krimarty/Siteshift_project/doc/treadmill_sideshift_doc/appendix.tex

\appendix
\section{Schematic diagram}
\section{PCB layout TOP (red) and BOTTOM (blue)}

\includepdf[pages=-,landscape]{images/1.0.0_20250715.pdf}

\begin{figure}[h!]
    \centering
    
\end{figure}

\begin{figure}[h!]
    \centering
    
\end{figure}
