krimarty/Siteshift_project/doc/treadmill_sideshift_doc/main.tex

\documentclass{ol-softwaremanual}

% Packages used in this example
\usepackage{graphicx}  % for including images
\usepackage{microtype} % for typographical enhancements
\usepackage{minted}    % for code listings
\usepackage{amsmath}   % for equations and mathematics
\setminted{style=friendly,fontsize=\small}
\renewcommand{\listoflistingscaption}{List of Code Listings}
\usepackage{hyperref}  % for hyperlinks
\usepackage[a4paper,top=4.2cm,bottom=4.2cm,left=3.5cm,right=3.5cm]{geometry} % for setting page size and margins
\usepackage{svg} % práce se SVG
\usepackage{xcolor}
\usepackage{dirtree}
\usepackage{pdfpages}

\newif\ifnotes
\notestrue   % ukázat poznámky
%\notesfalse

% příkaz pro poznámky
\newcommand{\note}[1]{%
  \ifnotes
    \textcolor{red}{#1}%
  \fi
}

% Custom macros used in this example document
\newcommand{\doclink}[2]{\href{#1}{#2}\footnote{\url{#1}}}
\newcommand{\cs}[1]{\texttt{\textbackslash #1}}

% Frontmatter data; appears on title page
\title{Treadmill sideshift \\ documentation}
\version{1.0.0}
\author{Martin Kriz}
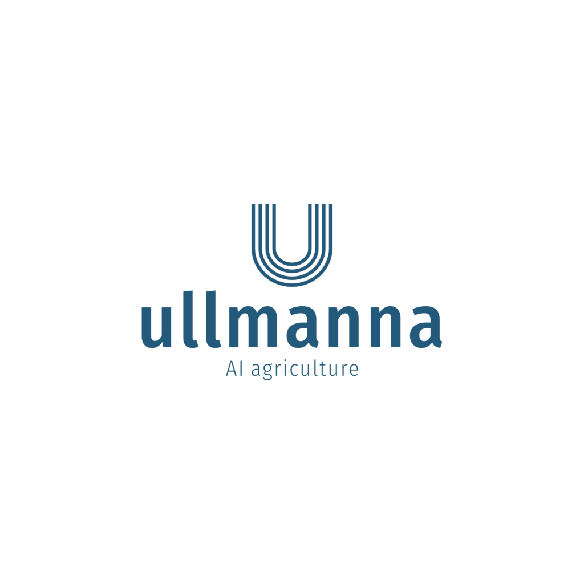
[picture p3: doc/treadmill_sideshift_doc/logo.png]
\softwarelogo{}

\begin{document}

\maketitle

\tableofcontents
\listoflistings
\newpage

\section{Introduction}

A PCB developed for a treadmill in the lab to provide lateral movement for testing the camera box. Two identical PCBs are used, controlling both ends of the treadmill.

\newpage
\section{Hardware}

\input{hardware}

\newpage
\section{Control panel}
\input{control_panel}

\newpage
\section{Software}

\input{software}

\newpage
\section{Appendix}

\input{appendix}

\end{document}
