krimarty/Siteshift_project/doc/treadmill_sideshift_doc.pdf

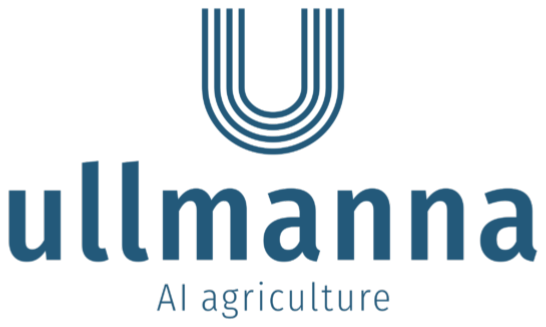
[picture p4: figure]

# Treadmill sideshift documentation

## Version 1.0.0

## Martin Kriz

August 27, 2025

## Contents

1 Introduction | 2
2 Hardware | 3
3 Control panel | 10
4 Software | 13
5 Appendix | 17
A Schematic diagram | 17
B PCB layout TOP (red) and BOTTOM (blue) | 17

## List of Code Listings

1

## 1 Introduction

A PCB developed for a treadmill in the lab to provide lateral movement for testing the camera box. Two identical PCBs are used, controlling both ends of the treadmill.

2

## 2 Hardware

### 2.1 Block diagram

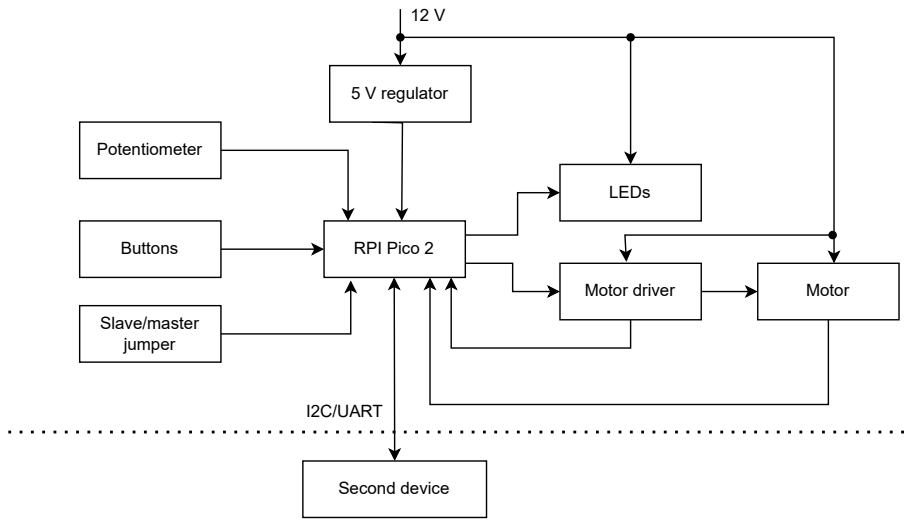
[picture p5: figure]
RPI Pico 2; Potentiometer; Buttons; Motor driver; Motor; LEDs; Slave/master jumper; Second device; I2C/UART; 5 V regulator

Figure 1: Block diagram of the treadmill sideshift module.

### 2.2 Motor Linak LA14

Exact model number is Linak 14020130000A0C06:

- Feedback: Hall potentiometer
- Motor type: 12 V BDC Fast
- Endstop: Power switch

The figure 2 shows the correct connection of the motor to the PCB.

3

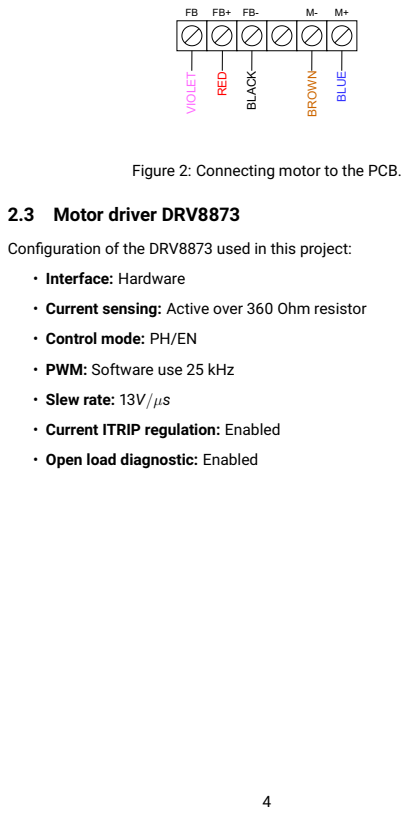
[picture p6: page 5]
M+BLUE BROWN BLACK RED VIOLET; 2.3 Motor driver DRV8873; • Interface: Hardware

Figure 2: Connecting motor to the PCB.

Configuration of the DRV8873 used in this project:

• Current sensing: Active over 360 Ohm resistor

• Control mode: PH/EN

• PWM: Software use 25 kHz

• Slew rate: 13V/µs

• Current ITRIP regulation: Enabled

• Open load diagnostic: Enabled

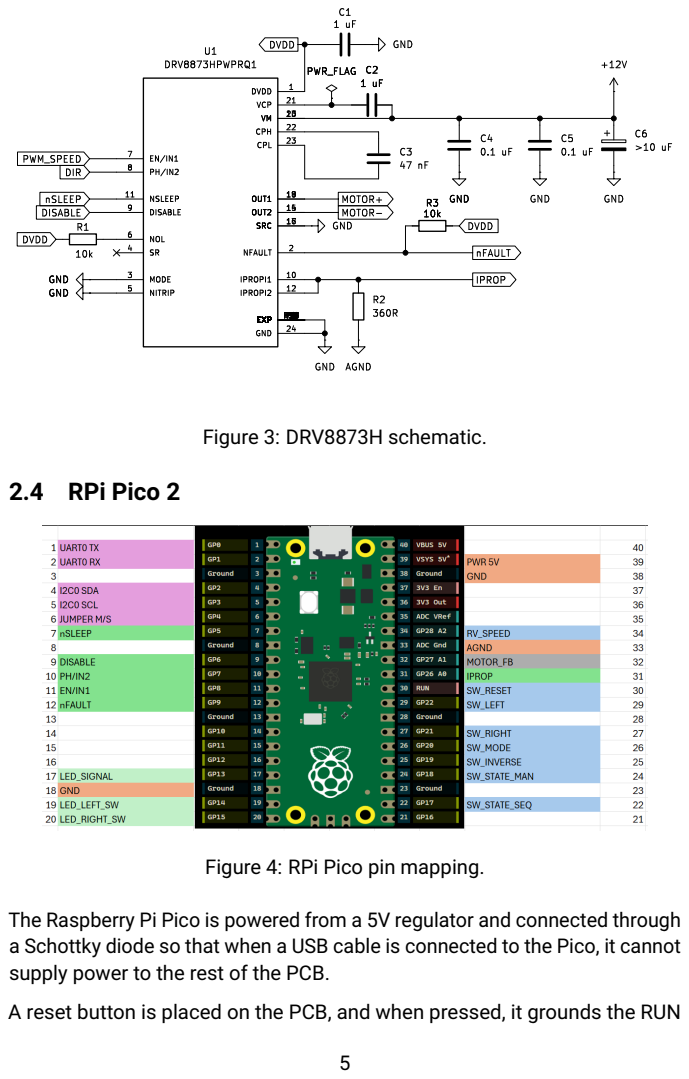
[picture p7: page 6]

Figure 4: RPi Pico pin mapping.

The Raspberry Pi Pico is powered from a 5V regulator and connected through
a Schottky diode so that when a USB cable is connected to the Pico, it cannot
supply power to the rest of the PCB.

A reset button is placed on the PCB, and when pressed, it grounds the RUN

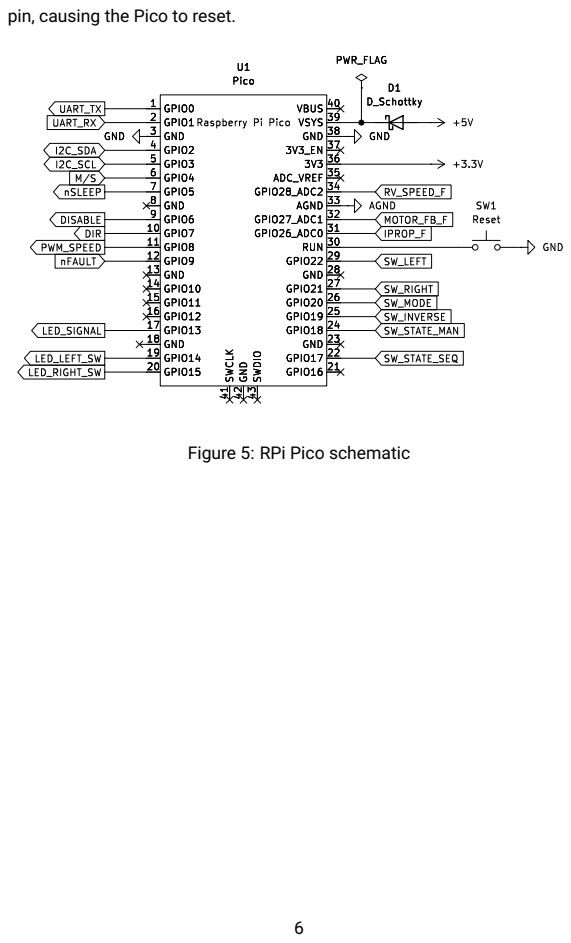
[picture p8: page 7]
pin, causing the Pico to reset.; AGND; PWR_FLAG; +5V D1 D_Schottky GND; GND GND; Raspberry; Pico GPIO0 1 GPIO7 10 GPIO8 11 GPIO9 12 GND 13 GPIO10 14 GPIO11 15 GPIO12 16 GPIO13 17 GND 18 GPIO14 19 GPIO1 2 GPIO15 20; GPIO16 21 GPIO17 22 GND 23 GPIO18 24 GPIO19 25 GPIO20 26 GPIO21 27 GND 28 GPIO22 29 GND 3; RUN 30 GPIO26_ADC0 31 GPIO27_ADC1 32 AGND 33 GPIO28_ADC2 34 ADC_VREF 35; 3V3_EN 37 GND 38 VSYS 39 GPIO2 4; VBUS 40 SWCLK 41; GND 42; SWDIO 43 GPIO3 5 GPIO4 6 GPIO5 7 GND 8 GPIO6 9; U1 Pico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

Figure 5: RPi Pico schematic

### 2.5 Power supply

An external 12 VDC power supply is connected to the board, which should be able to provide a current of at least 1.5 to 2 A.

The power input is 12 V is protected by a 5 A fuse based on Table 1, providing protection against reverse polarity and short circuits. In case of reverse polarity, the fuse must be replaced as it will be permanently damaged. As a 5V regulator, the LM7805 is used, and an LED is connected to it to indicate the voltage at the regulator’s output. See the schematic in figure 6.

Component | Supply Voltage (V) | Max Current (mA) | Power Source
RPI Pico | 5 | 100 | Regulator (7805)
Driver DRV8833 | 12 | 10 | Power supply
DC motor | 12 | 2500 | Driver
Motor feedback | 12 | 1 | Power supply
State LED | 12 | 20 | Power supply
Mode button LED | 12 | 20 | Power supply
PWR switch LED | 12 | 20 | Power supply

Table 1: Power consumption of individual components 1 2 SW_PWR2A

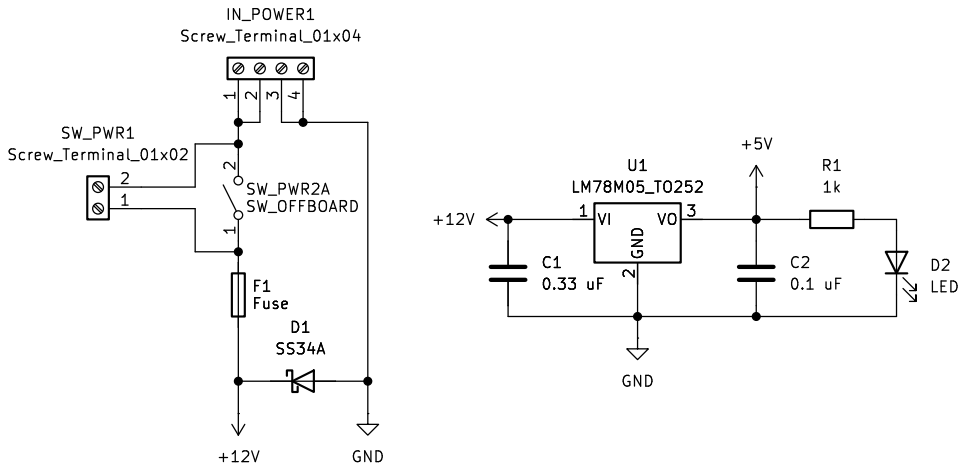
[picture p9: figure]
SW_OFFBOARD; F1Fuse D1 SS34A; 0.33 uF GND; GND; IN_POWER1 Screw_Terminal_01x04; 2 SW_PWR1 Screw_Terminal_01x02; LED; 1k F1Fuse D1 SS34A

Figure 6: Power supply schematic.

7

### 2.6 Analog circuits

All analog signals use simple RC low-pass filters, and their cutoff frequencies are listed in table 2. All analog sections also have a separate ground, AGND.

Signal | R | C | Cutoff frequency
Motor feedback | 10 kΩ | 1 µF | 15.9 Hz
Potentiometer | 10 kΩ | 1 µF | 15.9 Hz
Motor current | 10 kΩ | 3.3 nF | 4823 Hz

Table 2: RC Low-pass filters for analog signals

### 2.6.1 Motor current IPROP

The motor current is measured using the IPROPI1 and IPROPI2 pins, which are connected together for the purpose of this application. For converting the current into a voltage, the resistor Rsense is used, and its value is determined from the following equation:

Rsense =

k · Umax
I0

=

1100 · 3.3
10
= 360 Ω | (1)

### 2.6.2 Motor feedback

The motor feedback from the LINAK LA14 ranges from 0 to 10 V; a voltage divider is used to scale it down to 0–3.3 V for the Raspberry Pi Pico’s ADC. In addition, a safety margin is provided so that in the event of a fault, where a voltage of up to 12 V may appear on the pin, the ADC will not be damaged.

Uin[V] | R1 [Ω] | R2 [Ω] | Uout[V]
12 | 100k | 36k | 3.18

Table 3: Voltage divider for motor feedback input.

### 2.7 LEDs

For panel mounting, the LEDs need to be powered from 12 V. Therefore, the ULN2004A integrated circuit was used. To set the LED current to approxi-mately 20 mA, a series resistor of 470 Ω was chosen.The LED lights up when a logic high (1) is applied to the corresponding Raspberry Pi Pico pin.

8

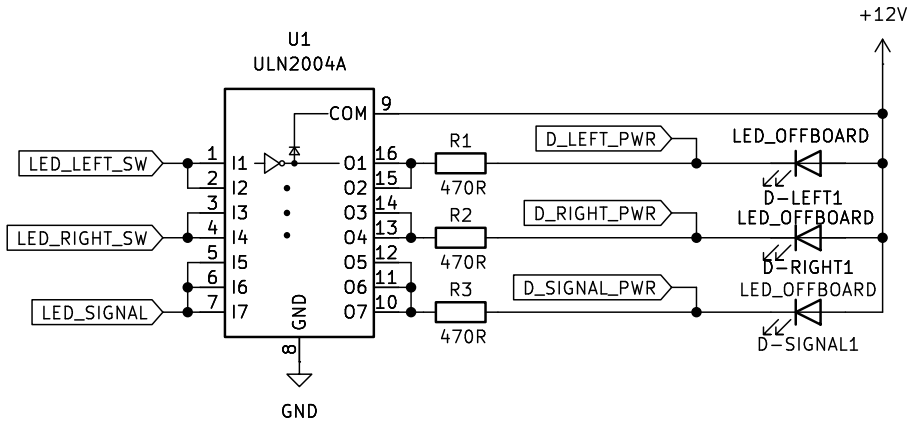
[picture p10: figure]
GND; 8 COM 9 U1 ULN2004A GND; D-LEFT1; LED_OFFBOARD; D-RIGHT1; D-SIGNAL1; LED_LEFT_SW; LED_RIGHT_SW; LED_SIGNAL; D_RIGHT_PWR; D_SIGNAL_PWR; D_LEFT_PWR; U1 ULN2004A; 8 COM 9 GND

I1 1 | O7 10 O6 11 O5 12 O4 13 O3 14 O2 15 O1 16
I1 1 | O7 10 O6 11 O5 12 O4 13 O3 14 O2 15 O1 16

Figure 7: LEDs schematic.

### 2.8 Communication

Communication with the second board is carried out via I²C or UART. When using the I²C bus, it is necessary to set whether the device acts as a master or a slave by means of a hardware jumper. It is necessary to ensure that one board has the jumper set to the slave position and the other board has the jumper set to the master bus position.

Figure 8: Master/Slave jumper.

For PCB version v1.0.0, the pin selected for I²C is incorrect, and it is not possible to operate it on the prepared pins. As a temporary solution, the I²C protocol can be used on the UART pins, where Tx corresponds to SDA and Rx corresponds to SCL. Therefore, when switching protocols, it is always necessary to swap the wires.

9

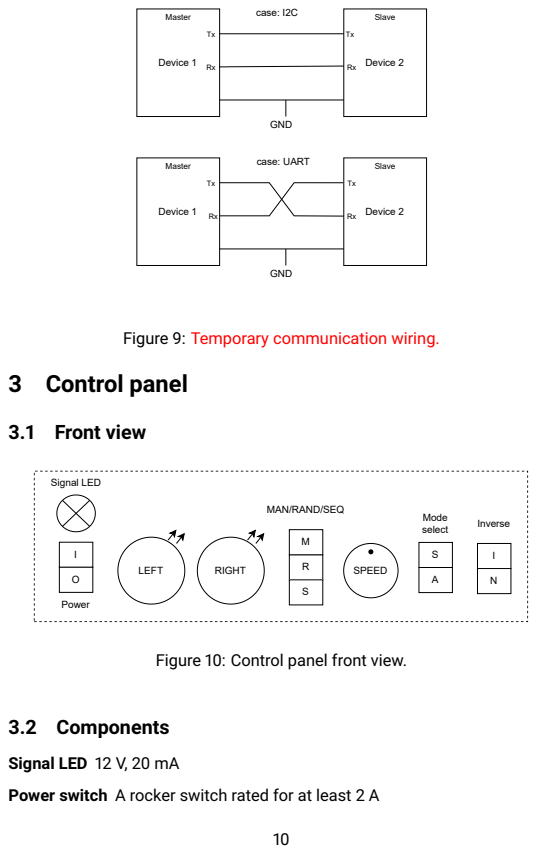
[picture p11: page 11]
Device 1; Device 2; GND; Master; Slave; case: I2C; case: UART; 3 Control panel; 3.1 Front view; LEFT; SPEED; Signal LED; Power; Mode select; RIGHT; Inverse; 3.2 Components

Figure 9: Temporary communication wiring.

MAN/RAND/SEQ

Figure 10: Control panel front view.

Signal LED 12 V, 20 mA

Power switch A rocker switch rated for at least 2 A

L/R button A non-latching push button with 12 V LED backlight.

State switch A three-position switch

Speed potentiometer 10 kΩ potentiometer

Mode/Inverse switch A two-position switch

### 3.3 Wiring

Each screw terminal for connection is marked with the number 1 on one side; numbering proceeds from that side. An example is shown in figure 11.

Figure 11: Screw terminal numbering.

### 3.4 Usage

After turning on the power using the power button, calibration starts auto-matically. Until the calibration is complete, the device cannot be controlled.

The higher a button is placed in this list, the higher its priority.

Mode switch Switches between the state of following the second device synchronous operation (SYN) or the asynchronous state (ASYN), where it is possible to control the device using the control panel.

State switch Three-position switch, allowing switching between manual control, random, and sequential modes. This switch is considered only when ASYN is selected on the previous button.

L/R buttons Buttons used to manually move the piston while held. These buttons are active only when the previous switch is set to the manual position. When the buttons are active, the LED backlight is illuminated.

Speed potentiometer In asynchronous mode, the potentiometer can be used to set the maximum speed of the piston movement.

11

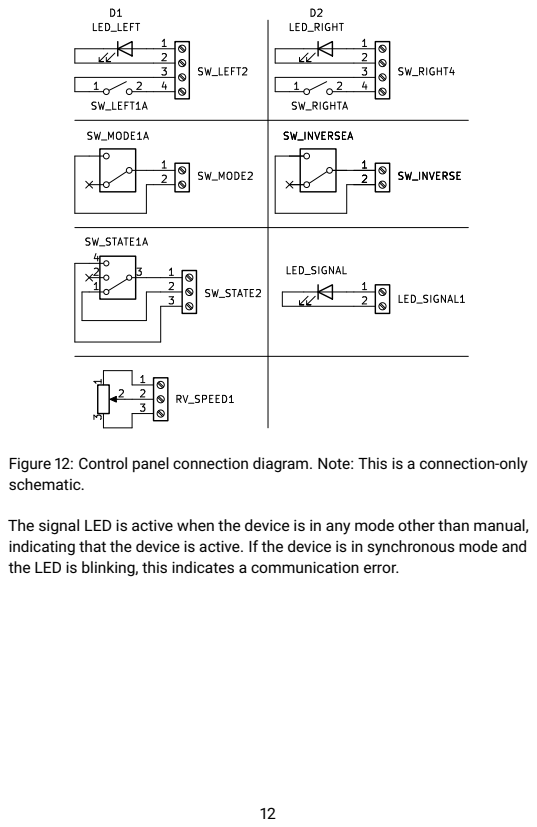
[picture p12: page 13]
SW_RIGHT4; SW_INVERSE; LED_SIGNAL1 D2; LED_RIGHT SW_MODE1A; SW_INVERSEA; 4 SW_STATE1A; SW_MODE2; SW_LEFT2 D1; LED_LEFT; 2 SW_LEFT1A; SW_STATE2; RV_SPEED1; LED_SIGNAL; 2 SW_RIGHTA; 2 SW_INVERSEA

Figure 12: Control panel connection diagram. Note: This is a connection-only
schematic.

The signal LED is active when the device is in any mode other than manual,
indicating that the device is active. If the device is in synchronous mode and
the LED is blinking, this indicates a communication error.

## 4 Software

The code is written in the Arduino IDE for the Raspberry Pi Pico2. The project structure is as follows:
treadmill_sideshift.ino | Main project file
src/
include/ .........Classes used by main hardware handling, algorithms
I2CCommunication.h | Provide I2C communication
ICommunication.h | Defines communication interface
Motor.h | Provide communication with the motor driver
MotorFeedback.h | Reading analog feedback from motor
OtherDevice.h ......Defines communication message, store the last message
Pid.h | PID controller with integral windup protection
PositionCalculator.h .converts raw ADC readings from a motor piston sensor into a physical position
UARTCommunication.h | Provide I2C communication
UserInterface.h ........handles buttons, potentiometer, and LED indicators
test/ | Codes for solo hardware testing, other device simulation
ICommunication_test/
Motor_test/
MotorFeedback_test/
SynMode_test/
UserInterface_test/

The properties of the classes are defined in the headers of the individual files.

### 4.1 State machine

State description:

- CALIB_LEFT – Initial state, used to find the maximum ADC value of the transducer, which is then stored to determine the exact position of the piston at its extreme end. The maximum is determined by running the motor until its position no longer changes for a certain period of time.
- CALIB_RIGHT – The same, but in this case it concerns the minimum ADC value of the transducer.

13

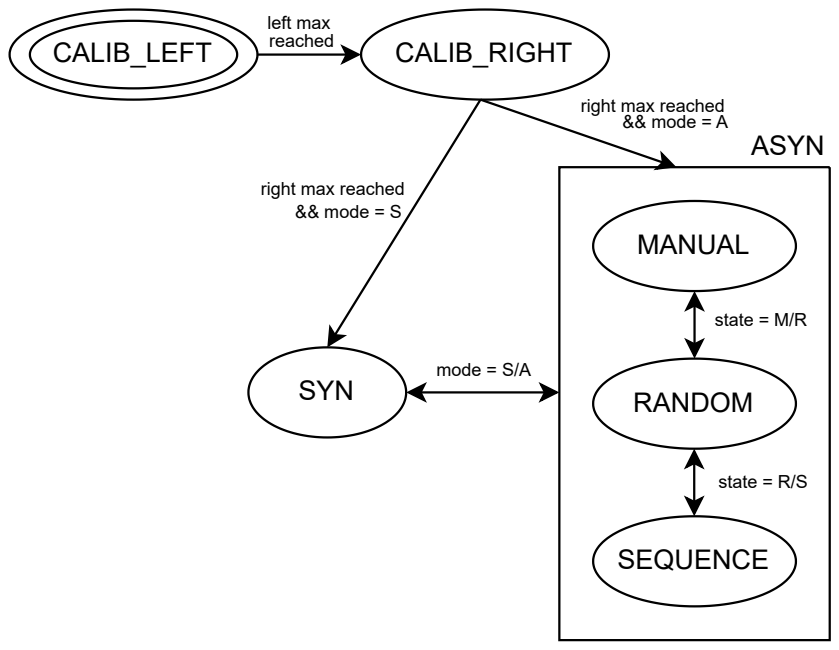
[picture p13: figure]
CALIB_RIGHT; SYN; MANUAL; RANDOM; SEQUENCE; ASYN; CALIB_LEFT; state = M/R; state = R/S; mode = S/A; && mode = S; && mode = A; reached; right max reached; left max

Figure 13: Sideshift state machine.

- SYN – State in which the piston follows the second piston (position is known via communication). A PI controller is used to maintain zero control deviation.
- MANUAL – Manual control is active, allowing the piston to be posi-tioned using the L/R buttons. The maximum speed is selected via a potentiometer.
- RANDOM – In random mode, a position is selected within the range of the piston rod, and a PI controller drives the rod to the selected position. After reaching the position, the next position is selected randomly. Maximum speed is set via a potentiometer.
- SEQUENCE – The piston rod moves left and right, with the maximum speed set via a potentiometer.

Transitions between states

14

- MAX REACHED – The maximum (minimum) is considered reached if the motor is driven in one direction, and the ADC converter value does not change by more than the interval defined in the constant changeTolerance during the time interval defined in the constant stableThreshold.
- STATE and MODE – These transitions depend on the position of the switches on the control panel.

### 4.2 Communication

### 4.2.1 Choosing protocol

For communication, it is necessary to correctly select the protocol, which is chosen in the setup loop. One of the following lines must be uncommented:

comm = new UARTCommunication();
//comm = new I2CCommunication(isMaster);

By enabling the UART protocol, a class is created that handles the communication. The protocols must be the same on both boards.

### 4.2.2 Message type

Messages are sent as strings. The OtherDevice class handles this conver-sion, and follows these rules:

- The message always starts with the character <.
- Values are separated by commas.
- The first value is the piston position (pos), represented as a floating-point number with two decimal places.
- The second value is the potentiometer reading (pot), represented as an integer.
- The third value is the direction (dir), represented as an integer.
- The message always ends with the character ;.

An example of a generated message:

<12.45,75,1;

15

Meaning of the message:

- pos = 12.45 → piston position in millimeters.
- pot = 75 → potentiometer value in percent (75 % of maximum speed).
- dir = 1 → piston movement direction.

### 4.2.3 Communication period

The communication period can be set by the constant COMM_MS in the main file. By default, it is set and tested to 50 ms.

16

## 5 Appendix

## A Schematic diagram

## B PCB layout TOP (red) and BOTTOM (blue)

17

# 1 uF GND

## 13 OUT2

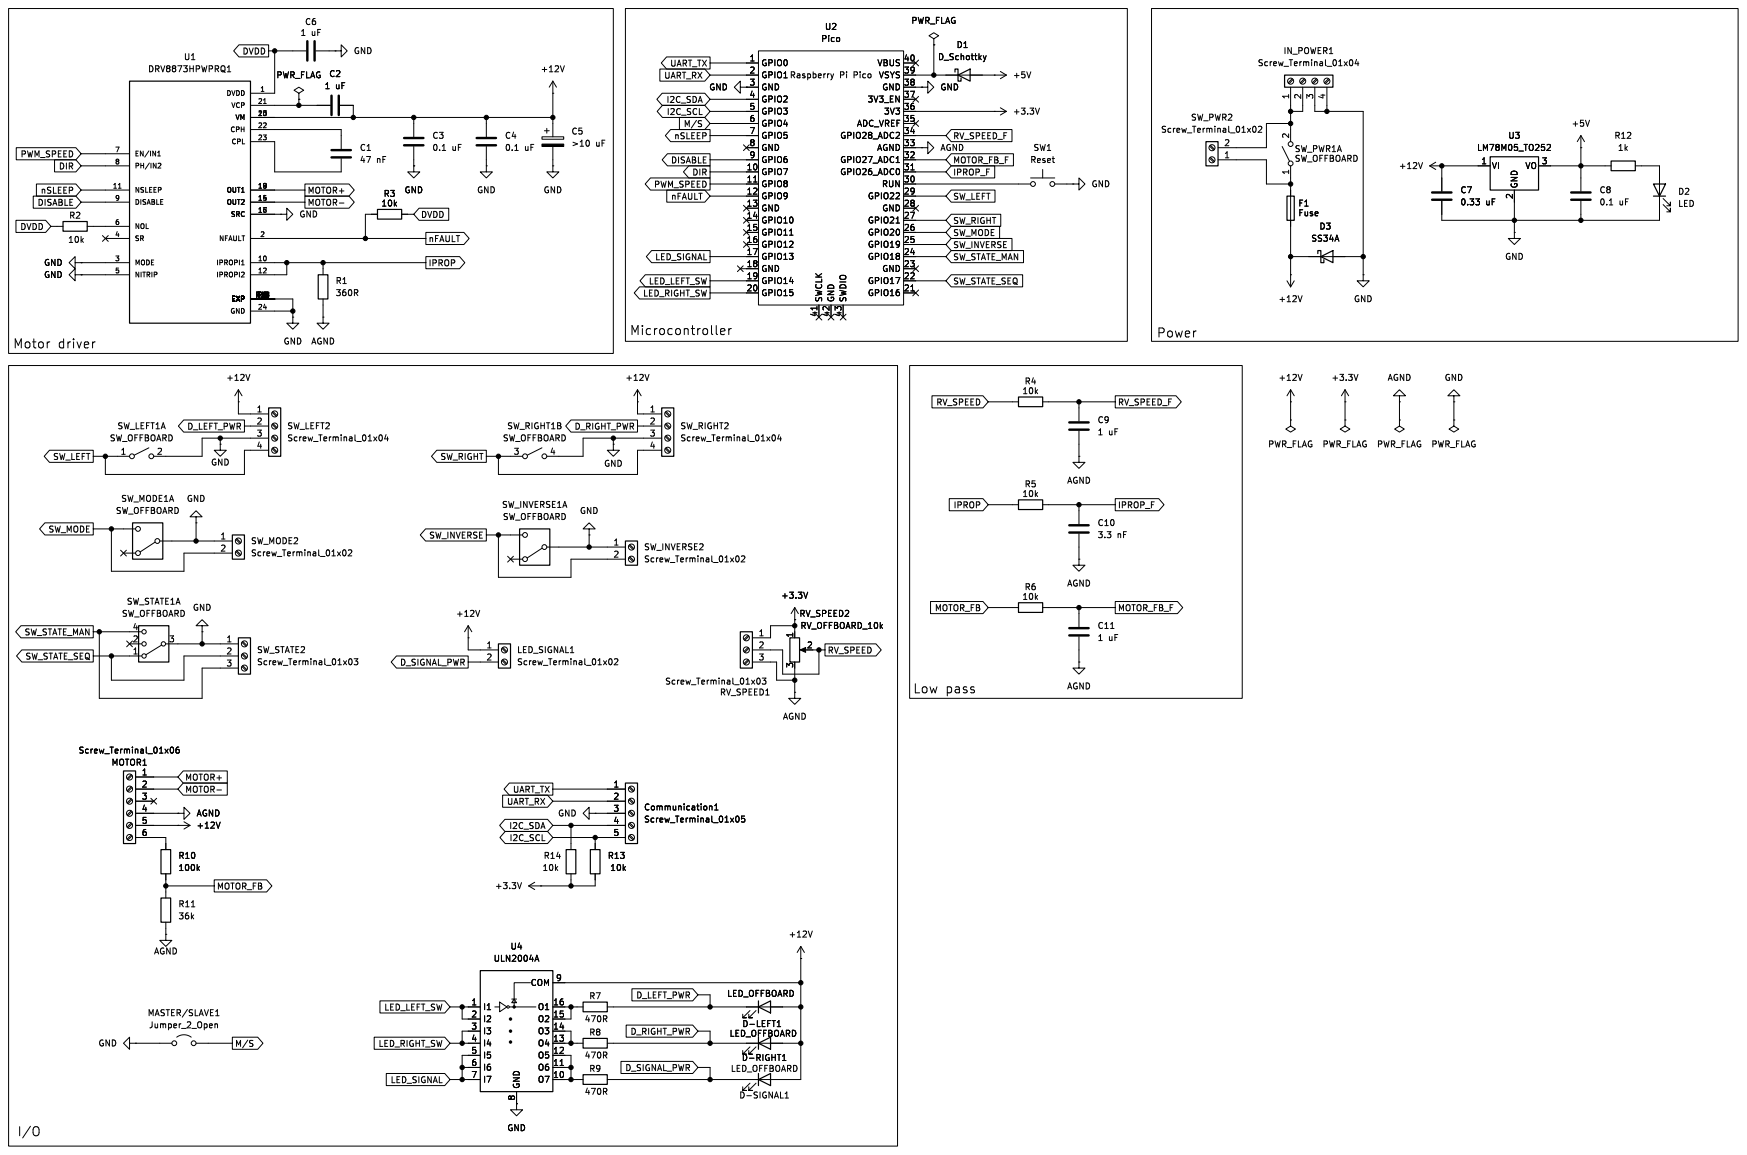
[picture p14: page 19]

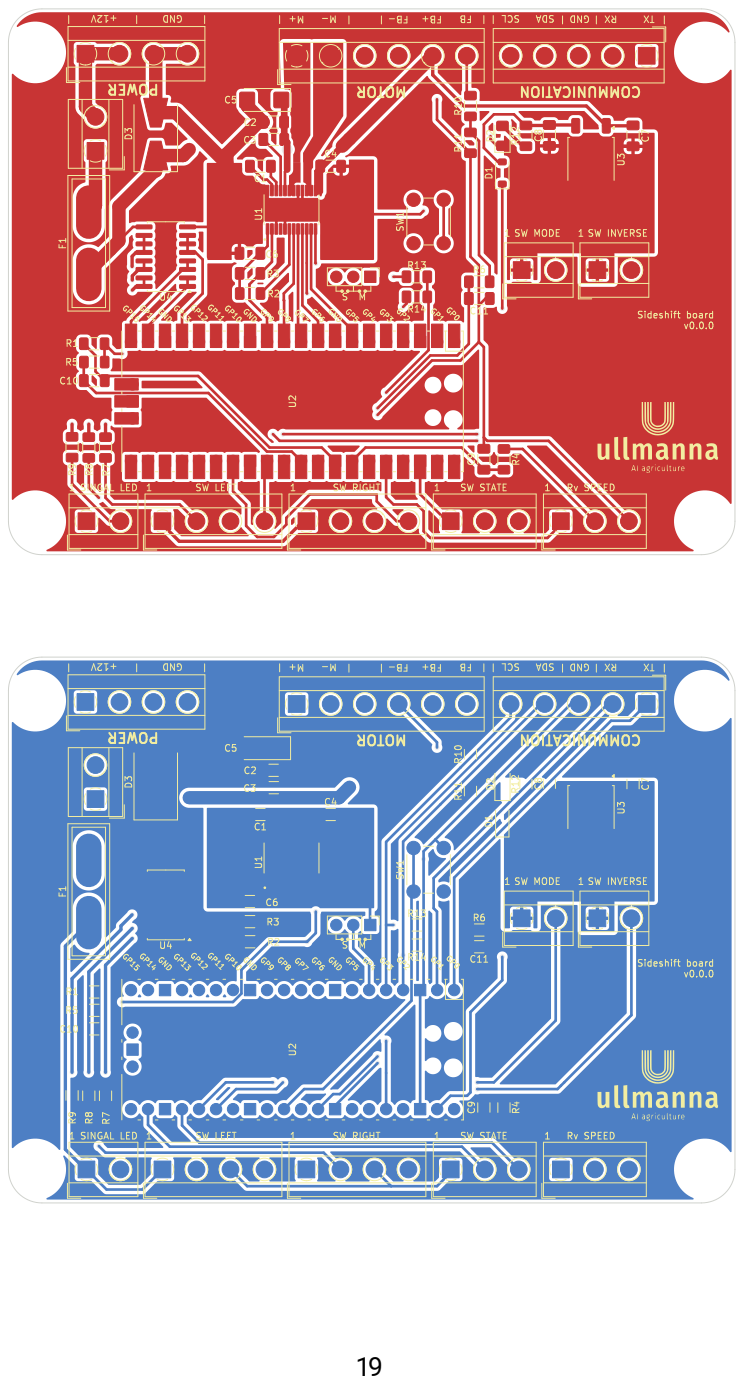
[picture p15: page 20]
