krimarty/Siteshift_project/doc/treadmill_sideshift_doc/images/sideshift_master_slave.pdf

Device 1 | Device 2

GND

Master | Slave
Tx | Tx
Rx | Rx
Device 1 | Device 2

GND

Master | Slave
Tx | Tx
Rx | Rx

case: I2C

case: UART
