krimarty/Siteshift_project/doc/treadmill_sideshift_doc/images/1.0.0_20250715.pdf

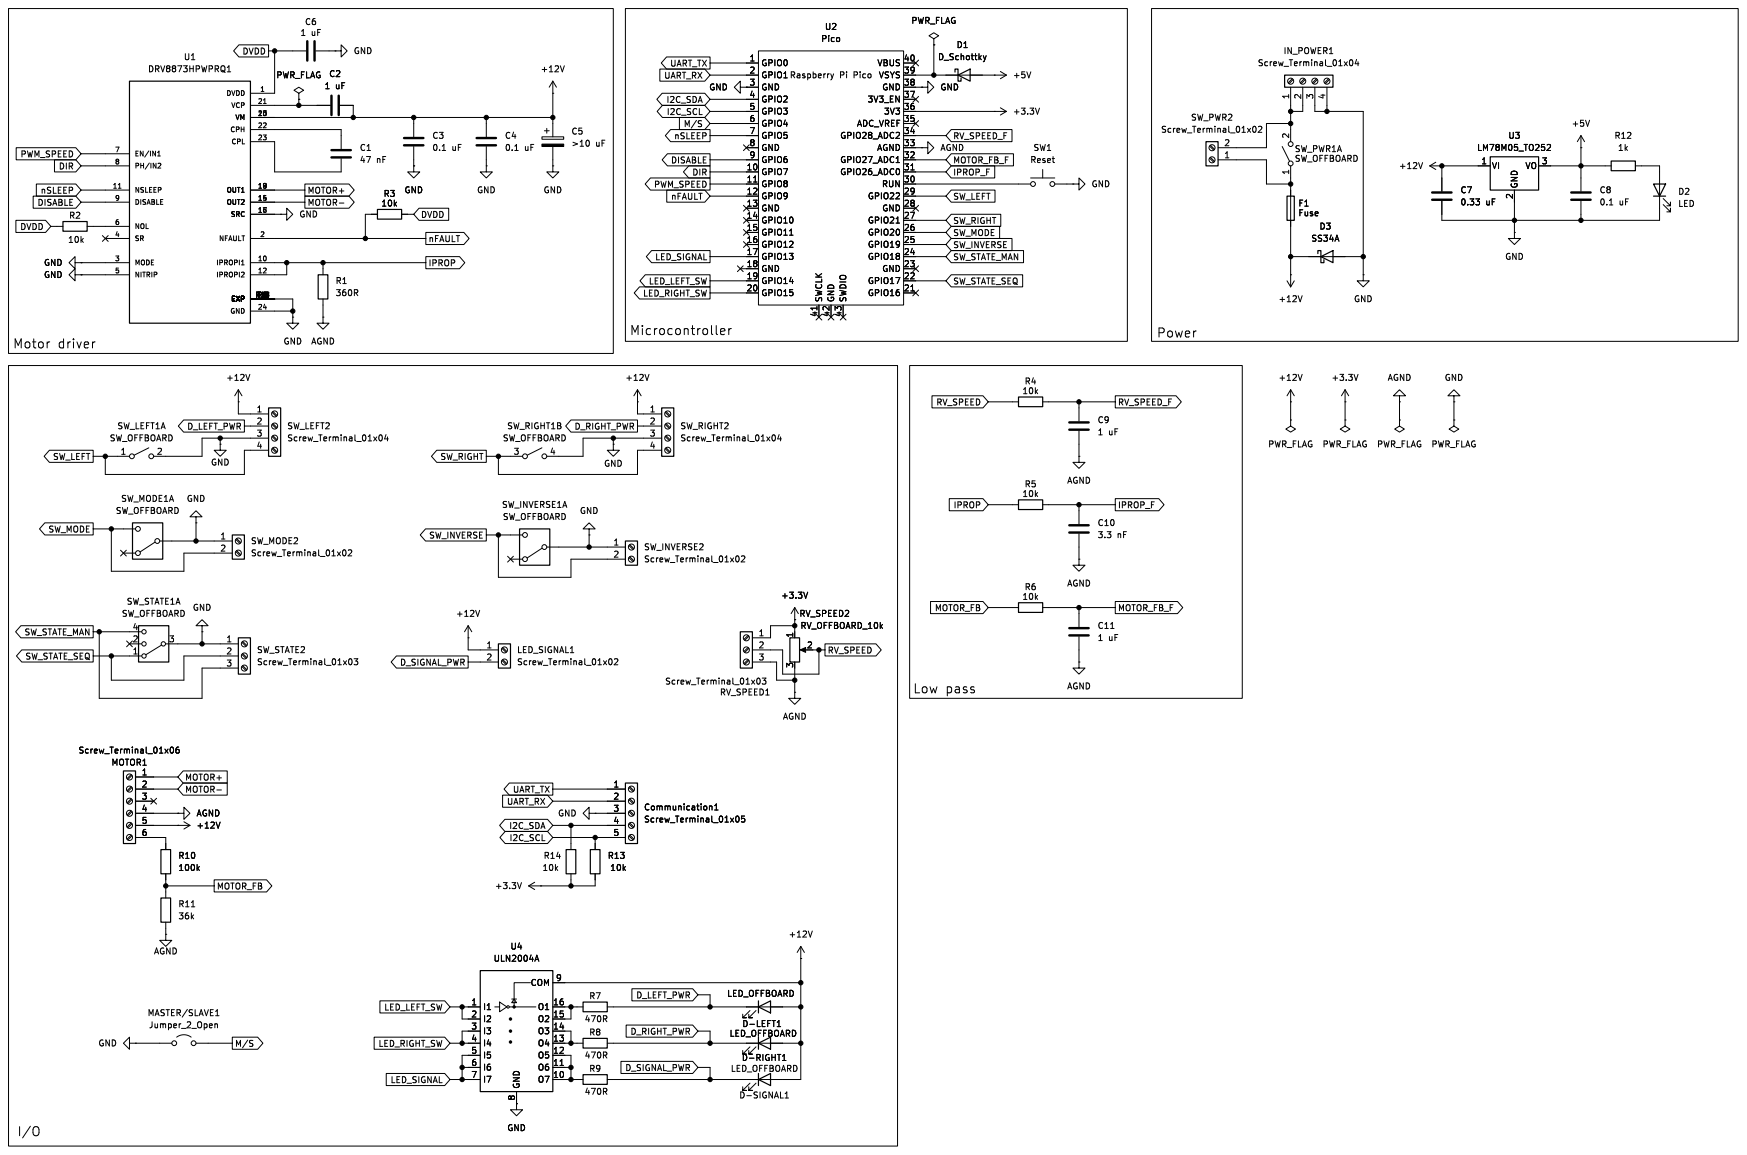
[picture p16: page 1]

2 VO 3 GND GND GND
DIR
