krimarty/Siteshift_project/doc/treadmill_sideshift_doc/images/siteshift_control_panel.pdf

# Signal LED IO

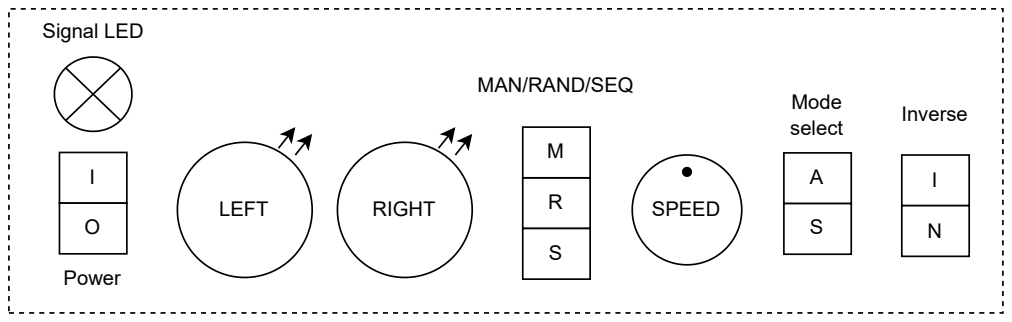
[picture p17: page 1]
LEFT; SPEED; Power; Mode select; RIGHT; MAN/RAND/SEQ M; Inverse
