krimarty/Siteshift_project/doc/treadmill_sideshift_doc/images/siteshift_frontview.drawio.pdf

# Signal LED IO

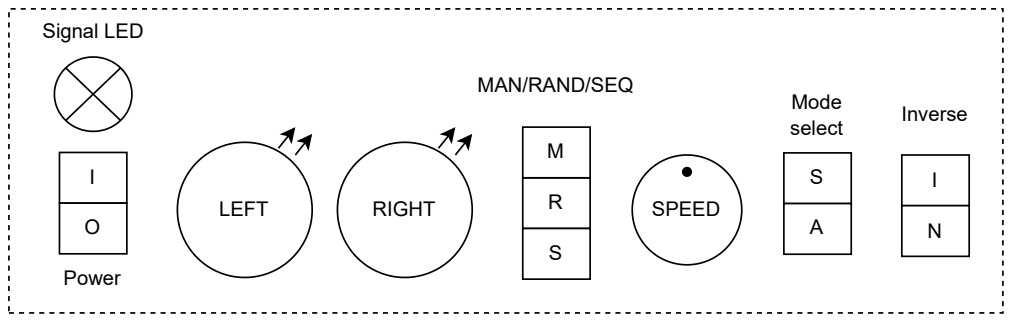
[picture p18: page 1]
LEFT; SPEED; Power; Mode select; RIGHT; MAN/RAND/SEQ M; Inverse
