krimarty/Siteshift_project/doc/treadmill_sideshift_doc/images/control_panel_schematic.pdf

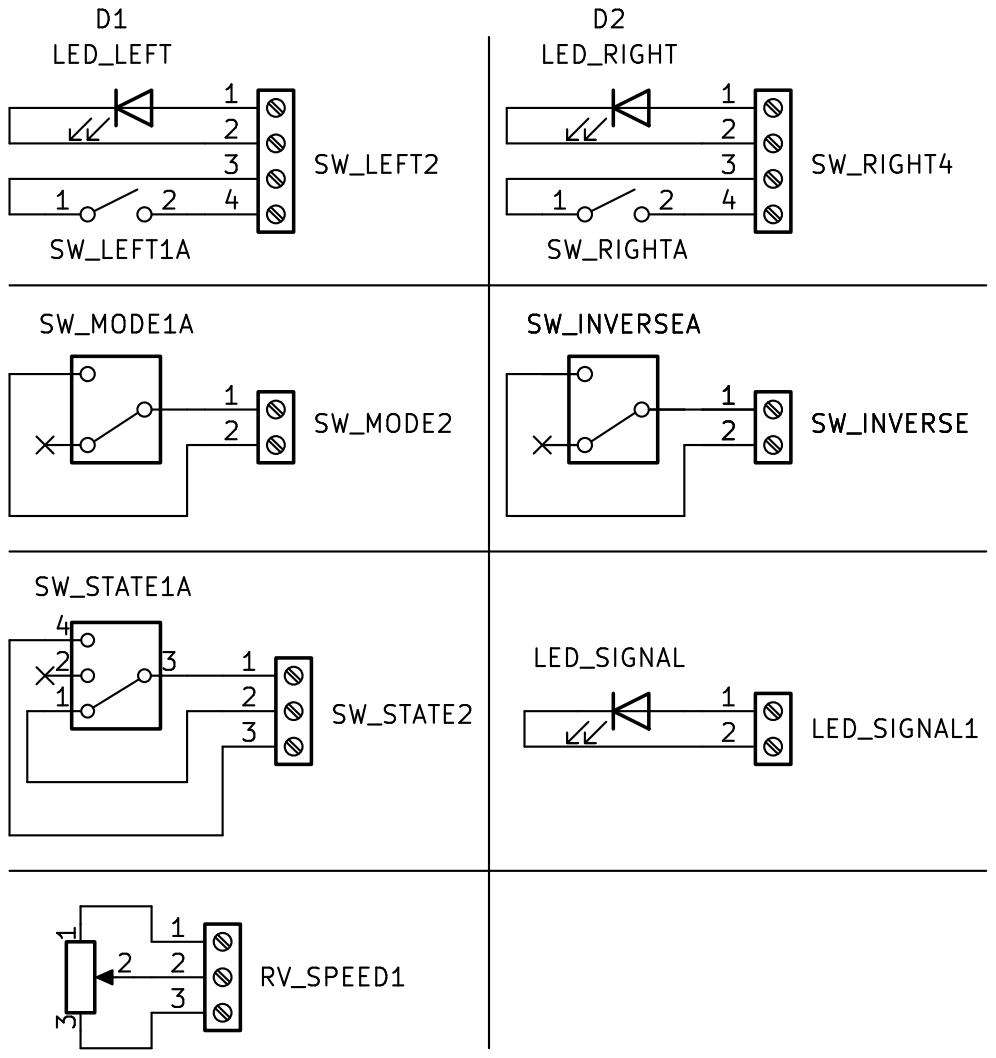
[picture p19: page 1]
