krimarty/Siteshift_project/doc/treadmill_sideshift_doc/images/DRV8873H_wiring.pdf

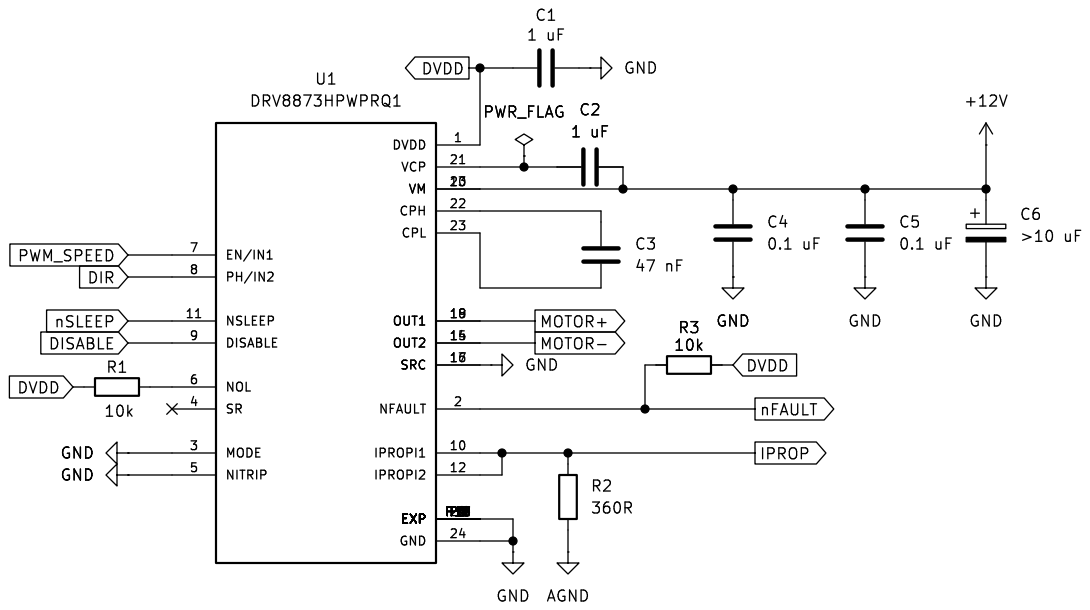
[picture p20: page 1]
