krimarty/Siteshift_project/doc/treadmill_sideshift_doc/images/leds_wiring.pdf

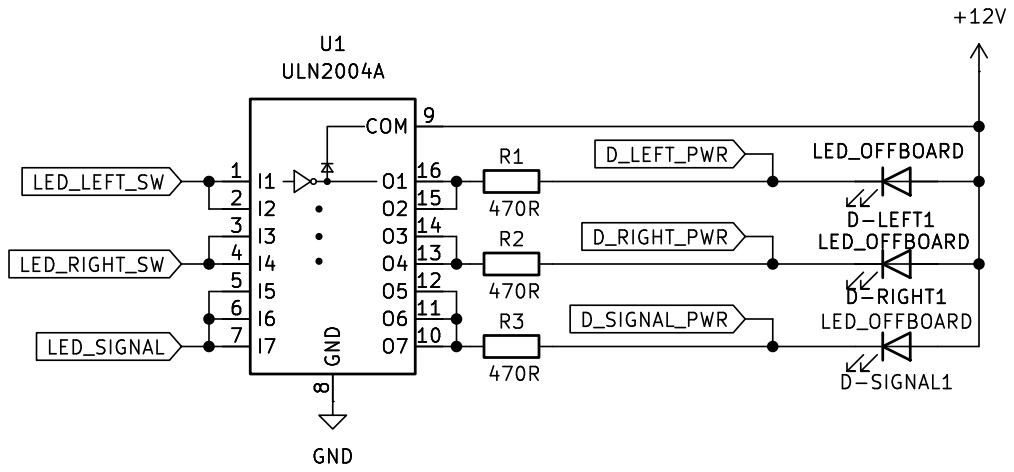
[picture p21: page 1]
