krimarty/Siteshift_project/doc/treadmill_sideshift_doc/images/motor_wiring.drawio.pdf

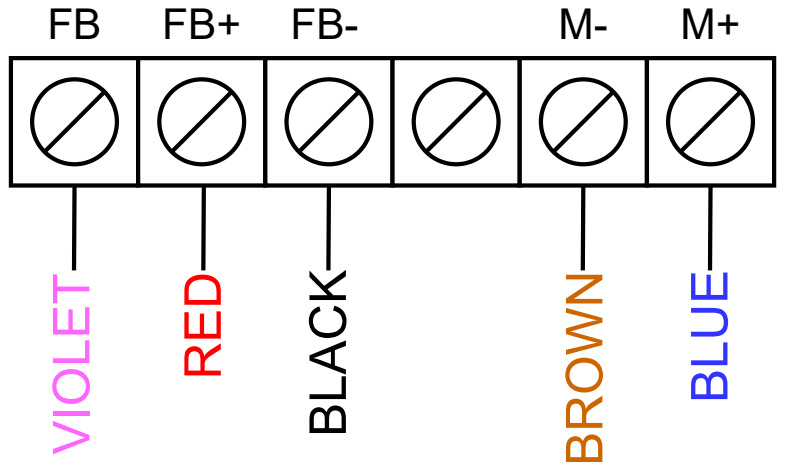
[picture p22: page 1]
M+BLUE BROWN BLACK RED VIOLET
