krimarty/Siteshift_project/doc/treadmill_sideshift_doc/images/pico_wiring.pdf

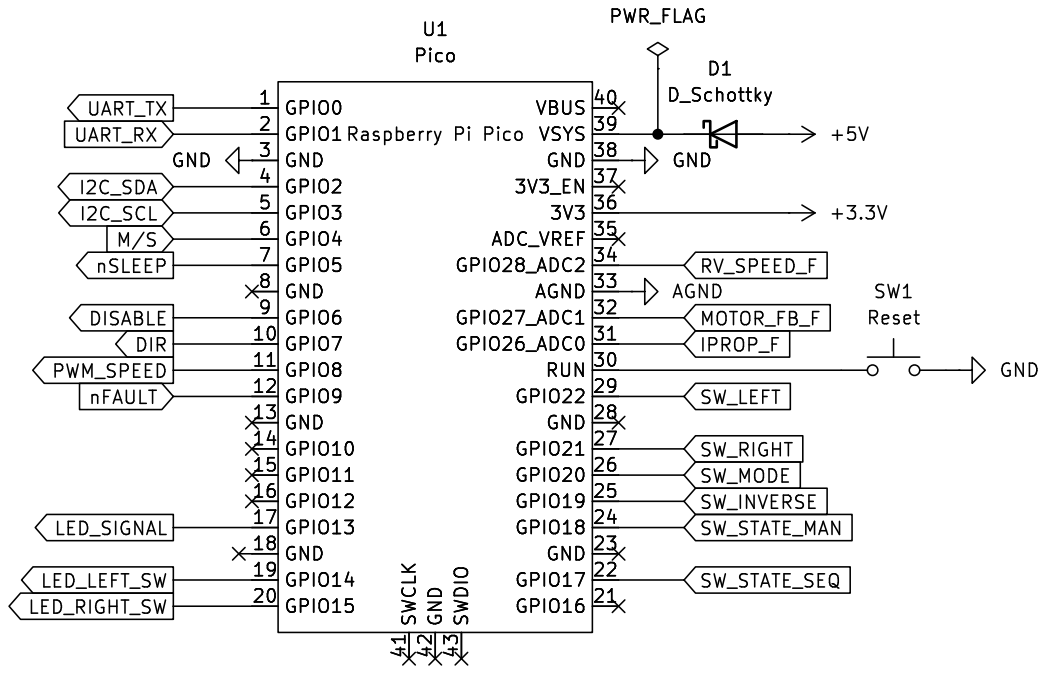
[picture p23: page 1]
