krimarty/Siteshift_project/doc/treadmill_sideshift_doc/images/power_schematic.pdf

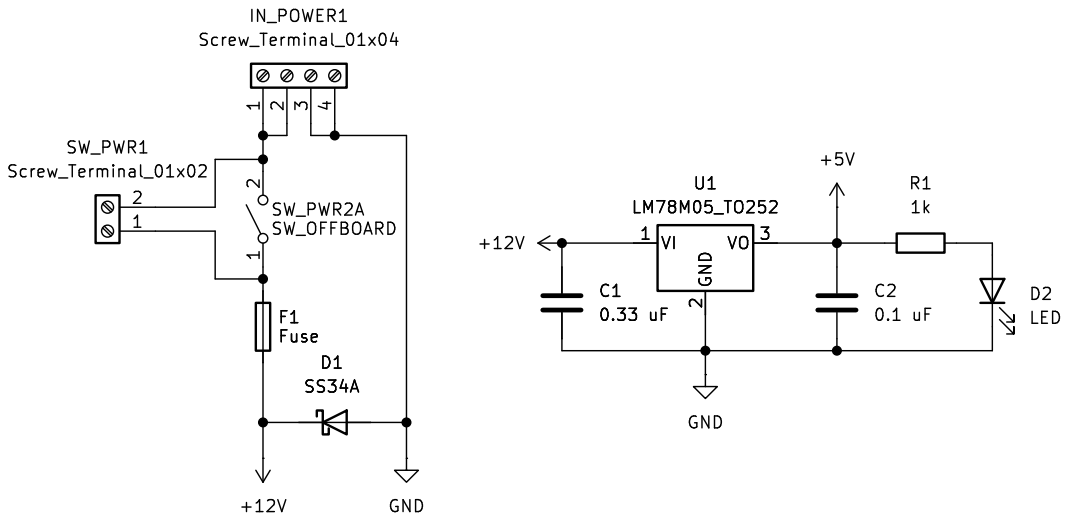
[picture p24: page 1]
