krimarty/Siteshift_project/doc/treadmill_sideshift_doc/images/sideshift_state-machine.drawio.pdf

## CALIB_RIGHT

## ASYN

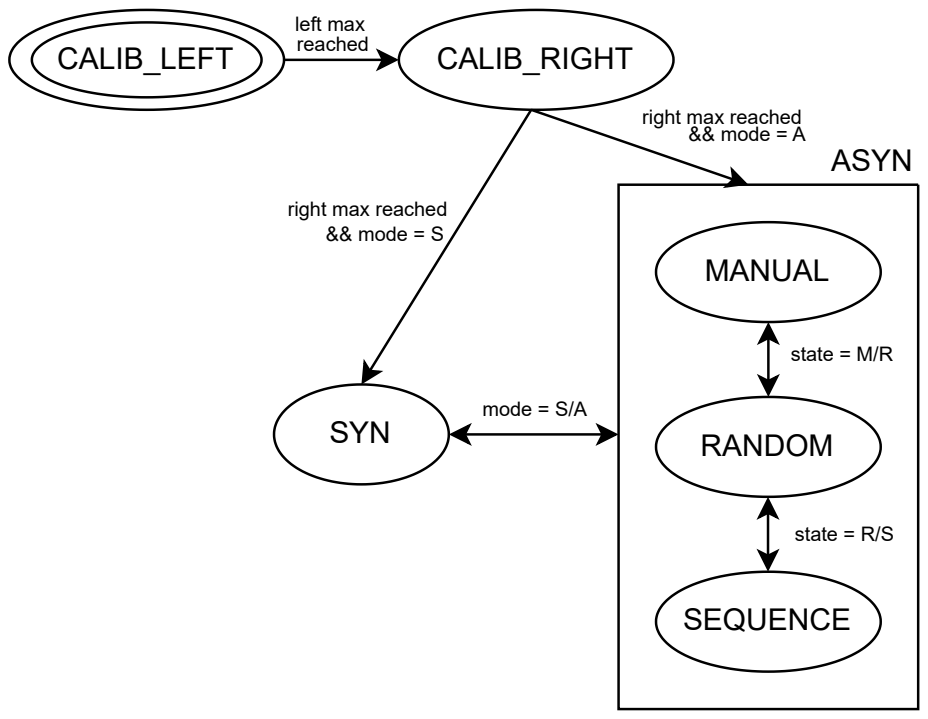
[picture p25: page 1]
SYN; MANUAL; RANDOM; SEQUENCE; CALIB_LEFT; state = M/R; state = R/S; mode = S/A; reached; left max

right max reached
&& mode = A

&& mode = S
