krimarty/Siteshift_project/doc/treadmill_sideshift_doc/images/siteshift-B_Cu.pdf

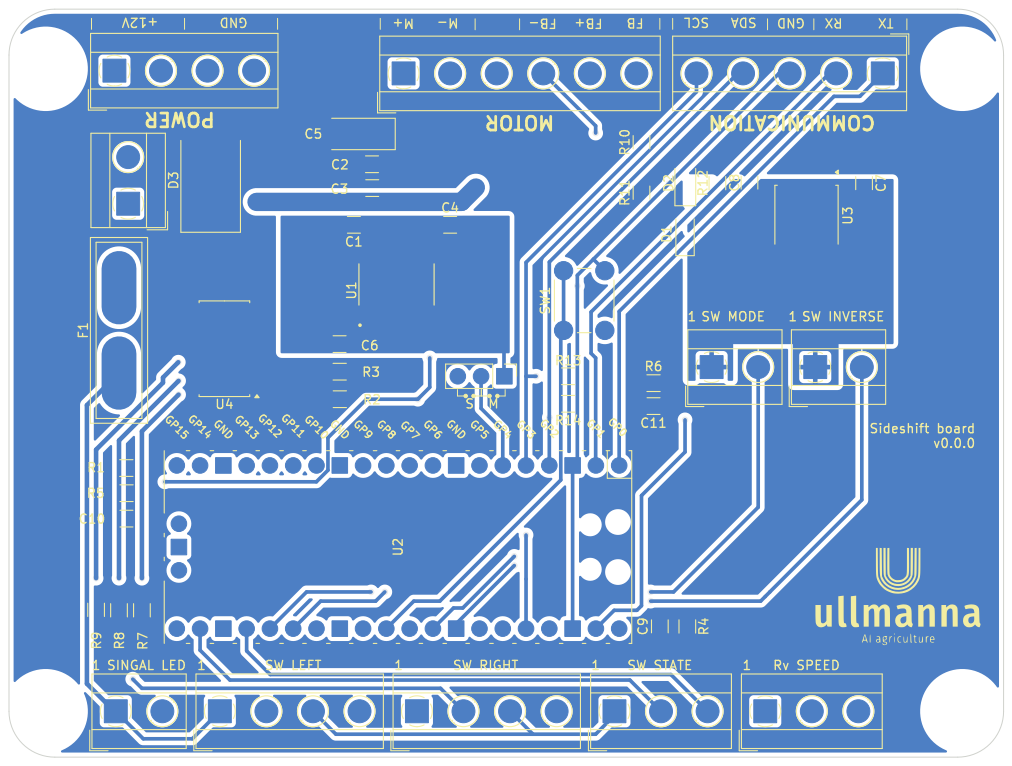
[picture p26: page 1]
