krimarty/Siteshift_project/doc/treadmill_sideshift_doc/images/siteshift-F_Cu.pdf

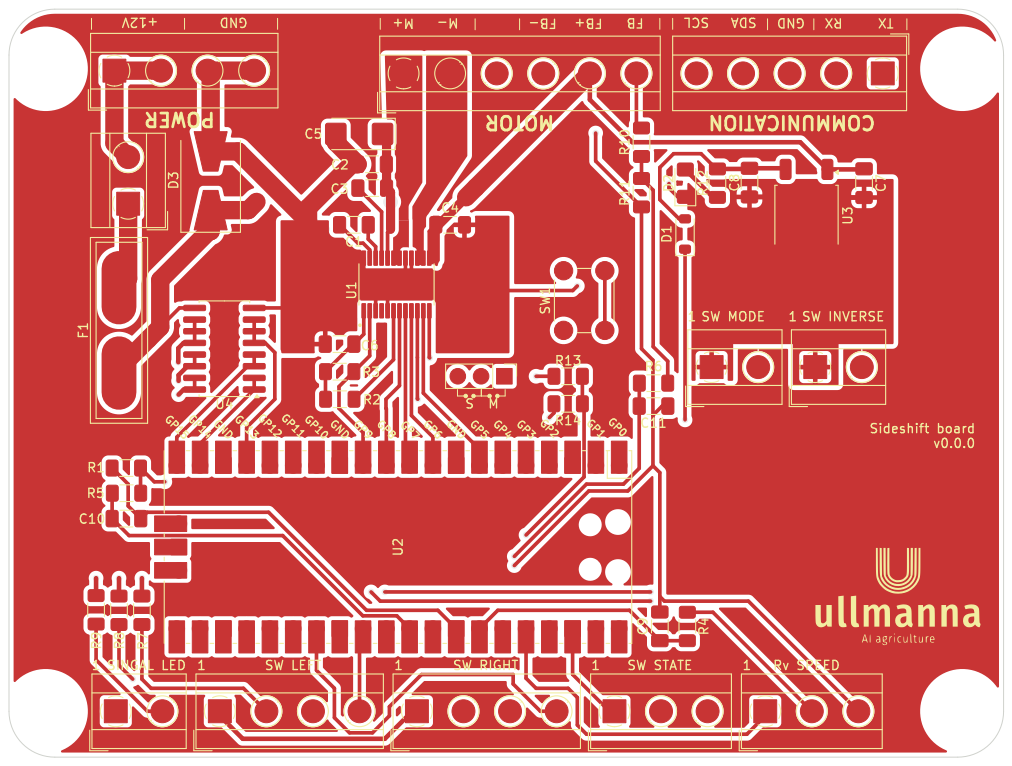
[picture p27: page 1]
