krimarty/Siteshift_project/kicad/siteshift/siteshift.kicad_pcb

## KiCad design kicad/siteshift/siteshift.kicad_pcb (2025-07-15)

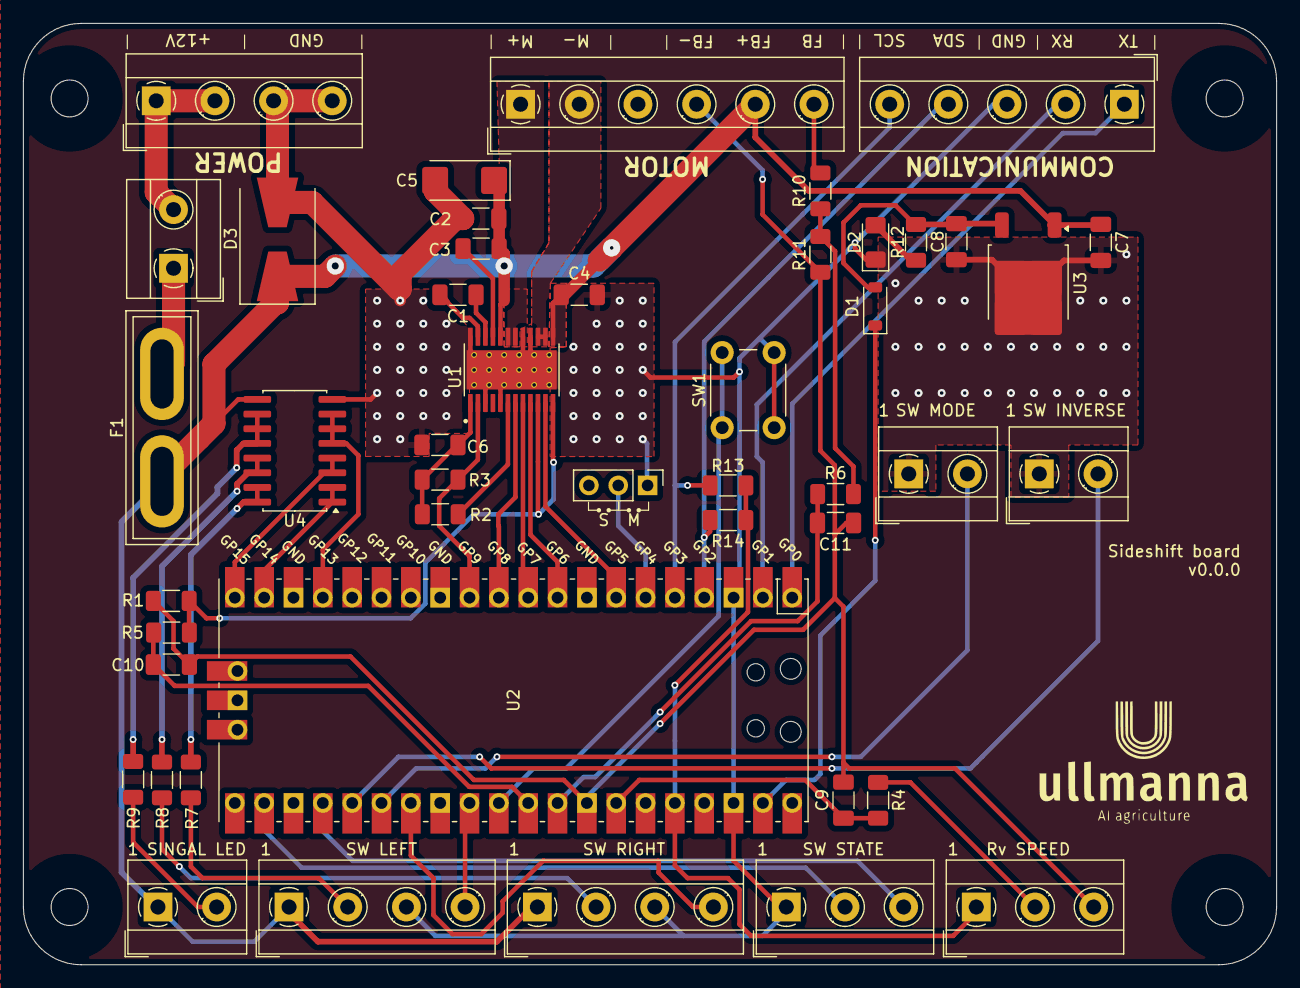
[picture p28: board siteshift.kicad_pcb from above]

Board: 2 copper layers, 108.5 x 81.5 mm, 50 parts (0 on the bottom side), 49 nets.

Parts:
C1: 47 nF; C_1206_3216Metric_Pad1.33x1.80mm_HandSolder
C2, C6, C9, C11: 1 uF; C_1206_3216Metric_Pad1.33x1.80mm_HandSolder
C3, C4, C8: 0.1 uF; C_1206_3216Metric_Pad1.33x1.80mm_HandSolder
C5: >10 uF; CP_EIA-6032-20_AVX-F_Pad2.25x2.35mm_HandSolder
C7: 0.33 uF; C_1206_3216Metric_Pad1.33x1.80mm_HandSolder
C10: 3.3 nF; C_1206_3216Metric_Pad1.33x1.80mm_HandSolder
Communication1: Screw_Terminal_01x05; TerminalBlock_MetzConnect_Type101_RT01605HBWC_1x05_P5.08mm_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
D1: D_Schottky; D_SOD-123
D2: LED; D_1206_3216Metric_Pad1.42x1.75mm_HandSolder
D3: SS34A; D_SMB-SMC_Universal_Handsoldering
F1: Fuse; Fuse_Blade_ATO_directSolder
H3, H3#2, H3#3, H3#4: MountingHole; MountingHole_3.2mm_M3
IN_POWER1: Screw_Terminal_01x04; TerminalBlock_MetzConnect_Type101_RT01604HBWC_1x04_P5.08mm_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
LED_SIGNAL1: Screw_Terminal_01x02; TerminalBlock_MetzConnect_Type101_RT01602HBWC_1x02_P5.08mm_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
MASTER/SLAVE1: Jumper_2_Open; PinHeader_1x03_P2.54mm_Vertical
MOTOR1: Screw_Terminal_01x06; TerminalBlock_MetzConnect_Type101_RT01606HBWC_1x06_P5.08mm_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
R1: 360R; R_1206_3216Metric_Pad1.30x1.75mm_HandSolder
R2, R3, R4, R5, R6, R13, R14: 10k; R_1206_3216Metric_Pad1.30x1.75mm_HandSolder
R7, R8, R9: 470R; R_1206_3216Metric_Pad1.30x1.75mm_HandSolder
R10: 100k; R_1206_3216Metric_Pad1.30x1.75mm_HandSolder
R11: 36k; R_1206_3216Metric_Pad1.30x1.75mm_HandSolder
R12: 1k; R_1206_3216Metric_Pad1.30x1.75mm_HandSolder
RV_SPEED1: Screw_Terminal_01x03; TerminalBlock_MetzConnect_Type101_RT01603HBWC_1x03_P5.08mm_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
SW1: Reset; SW_PUSH_6mm_H5mm
SW_INVERSE2: Screw_Terminal_01x02; TerminalBlock_MetzConnect_Type101_RT01602HBWC_1x02_P5.08mm_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
SW_LEFT2: Screw_Terminal_01x04; TerminalBlock_MetzConnect_Type101_RT01604HBWC_1x04_P5.08mm_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
SW_MODE2: Screw_Terminal_01x02; TerminalBlock_MetzConnect_Type101_RT01602HBWC_1x02_P5.08mm_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
SW_PWR2: Screw_Terminal_01x02; TerminalBlock_MetzConnect_Type101_RT01602HBWC_1x02_P5.08mm_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
SW_RIGHT2: Screw_Terminal_01x04; TerminalBlock_MetzConnect_Type101_RT01604HBWC_1x04_P5.08mm_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
SW_STATE2: Screw_Terminal_01x03; TerminalBlock_MetzConnect_Type101_RT01603HBWC_1x03_P5.08mm_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
U1: DRV8873HPWPRQ1; SOP65P640X120-25N
U2: Pico; RPi_Pico_SMD_TH
U3: LM78M05_TO252; TO-252-2
U4: ULN2004A; SOIC-16W_5.3x10.2mm_P1.27mm

Connections:
+3.3V: R13.1, R14.1, RV_SPEED1.1, U2.36 (3V3)
+5V: C8.1, D1.2 (A), R12.2, U3.3 (VO)
+12V: C2.2, C3.1, C4.1, C5.1, C7.1, D3.1 (K), F1.1, LED_SIGNAL1.1, MOTOR1.5, SW_LEFT2.1, SW_RIGHT2.1, U1.13 (VM), U1.20 (VM), U3.1 (VI), U4.9 (COM)
AGND: C9.2, C10.2, C11.2, MOTOR1.4, R1.1, R11.1, RV_SPEED1.3, U2.33 (AGND)
DIR: U1.8 (PH/IN2), U2.10 (GPIO7)
DISABLE: U1.9 (DISABLE), U2.9 (GPIO6)
DVDD: C6.1, R2.1, R3.1, U1.1 (DVDD)
D_LEFT_PWR: R7.1, SW_LEFT2.2
D_RIGHT_PWR: R8.1, SW_RIGHT2.2
D_SIGNAL_PWR: LED_SIGNAL1.2, R9.1
GND: C3.2, C4.2, C5.2, C6.2, C7.2, C8.2, Communication1.3, D2.1 (K), D3.2 (A), IN_POWER1.3, IN_POWER1.4, MASTER/SLAVE1.1 (A), SW1.2, SW_INVERSE2.1, SW_LEFT2.3, SW_MODE2.1, SW_RIGHT2.3, SW_STATE2.1, U1.3 (MODE), U1.5 (NITRIP), U1.16 (SRC), U1.17 (SRC), U1.24 (GND), U1.25 (EXP), U1.P1 (EXP), U1.P2 (EXP), U1.P3 (EXP), U1.P4 (EXP), U1.P5 (EXP), U1.P6 (EXP), U1.P7 (EXP), U1.P8 (EXP), U1.P9 (EXP), U1.P10 (EXP), U1.P11 (EXP), U1.P12 (EXP), U1.P13 (EXP), U1.P14 (EXP), U1.P15 (EXP), U1.P16 (EXP), U1.P17 (EXP), U1.P18 (EXP), U2.3 (GND), U2.38 (GND), U3.2 (GND), U4.8 (GND)
I2C_SCL: Communication1.5, R13.2, U2.5 (GPIO3)
I2C_SDA: Communication1.4, R14.2, U2.4 (GPIO2)
IPROP: R1.2, R5.2, U1.10 (IPROPI1), U1.12 (IPROPI2)
IPROP_F: C10.1, R5.1, U2.31 (GPIO26_ADC0)
LED_LEFT_SW: U2.19 (GPIO14), U4.1 (I1), U4.2 (I2)
LED_RIGHT_SW: U2.20 (GPIO15), U4.3 (I3), U4.4 (I4)
LED_SIGNAL: U2.17 (GPIO13), U4.5 (I5), U4.6 (I6), U4.7 (I7)
MOTOR+: MOTOR1.1, U1.18 (OUT1), U1.19 (OUT1)
MOTOR-: MOTOR1.2, U1.14 (OUT2), U1.15 (OUT2)
MOTOR_FB: R6.2, R10.1, R11.2
MOTOR_FB_F: C11.1, R6.1, U2.32 (GPIO27_ADC1)
M/S: MASTER/SLAVE1.2 (B), U2.6 (GPIO4)
unnamed: D1.1 (K), U2.39 (VSYS)
unnamed: D2.2 (A), R12.1
unnamed: IN_POWER1.1, IN_POWER1.2, SW_PWR2.2
unnamed: MOTOR1.6, R10.2
unnamed: F1.2, SW_PWR2.1
unnamed: C1.1, U1.22 (CPH)
unnamed: C1.2, U1.23 (CPL)
unnamed: R2.2, U1.6 (NOL)
unnamed: C2.1, U1.21 (VCP)
unnamed: SW1.1, U2.30 (RUN)
unnamed: R7.2, U4.15 (O2), U4.16 (O1)
unnamed: R8.2, U4.13 (O4), U4.14 (O3)
unnamed: R9.2, U4.10 (O7), U4.11 (O6), U4.12 (O5)
PWM_SPEED: U1.7 (EN/IN1), U2.11 (GPIO8)
RV_SPEED: R4.2, RV_SPEED1.2
RV_SPEED_F: C9.1, R4.1, U2.34 (GPIO28_ADC2)
SW_INVERSE: SW_INVERSE2.2, U2.25 (GPIO19)
SW_LEFT: SW_LEFT2.4, U2.29 (GPIO22)
SW_MODE: SW_MODE2.2, U2.26 (GPIO20)
SW_RIGHT: SW_RIGHT2.4, U2.27 (GPIO21)
SW_STATE_MAN: SW_STATE2.3, U2.24 (GPIO18)
SW_STATE_SEQ: SW_STATE2.2, U2.22 (GPIO17)
UART_RX: Communication1.2, U2.2 (GPIO1)
UART_TX: Communication1.1, U2.1 (GPIO0)
nFAULT: R3.2, U1.2 (NFAULT), U2.12 (GPIO9)
nSLEEP: U1.11 (NSLEEP), U2.7 (GPIO5)
