krimarty/Siteshift_project/firmware/treadmill_sideshift/include/UserInterface.h

/* =============================================================
 * Project:   treadmill_sideshift
 * File:      UserInterface.h
 * Author:    Martin Kriz
 * Company:   Ullmanna s.r.o.
 * Created:   2025-08-20
 * -------------------------------------------------------------
 * Description:
 *   This header defines the UserInterface class, which handles
 *   buttons, potentiometer, and LED indicators for the treadmill
 *   sideshift project. Provides direction reading, mode selection,
 *   inverse switch, LED control and potentiometer reading.
 *
 * Notes:
 * ============================================================= */

#pragma once
#include <Arduino.h>

// Pin assignment
constexpr int PIN_POT      = 28;
constexpr int PIN_BTN_LEFT = 22;
constexpr int PIN_BTN_RIGHT= 21;
constexpr int PIN_MODE     = 20;
constexpr int PIN_INVERSE  = 19;
constexpr int PIN_MAN      = 18;
constexpr int PIN_SEQ      = 17;
constexpr int PIN_LED_SIGNAL = 13;
constexpr int PIN_LED_LEFT   = 14;
constexpr int PIN_LED_RIGHT  = 15;

enum class ModeType {
    MANUAL,
    RANDOM,
    SEQUENCE
};

enum class Direction {
    LEFT,
    RIGHT,
    STOP
};
class UserInterface {
private:   
    bool isLeftPressed()  { return digitalRead(PIN_BTN_LEFT)  == LOW; }
    bool isRightPressed() { return digitalRead(PIN_BTN_RIGHT) == LOW; }
    
public:
    UserInterface() {
        pinMode(PIN_POT, INPUT);
        pinMode(PIN_BTN_LEFT, INPUT_PULLUP);
        pinMode(PIN_BTN_RIGHT, INPUT_PULLUP);
        pinMode(PIN_MODE, INPUT_PULLUP);
        pinMode(PIN_INVERSE, INPUT_PULLUP);
        pinMode(PIN_MAN, INPUT_PULLUP);
        pinMode(PIN_SEQ, INPUT_PULLUP);
        pinMode(PIN_LED_SIGNAL, OUTPUT);
        pinMode(PIN_LED_LEFT, OUTPUT);
        pinMode(PIN_LED_RIGHT, OUTPUT);
    }

    Direction getDirection() {
        if (isLeftPressed() && isRightPressed()) {
            return Direction::STOP;
        }
        else if (isLeftPressed()) {
            return Direction::LEFT;
        } else if (isRightPressed()) {
            return Direction::RIGHT;
        } else {
            return Direction::STOP;
        }
    }

    int getDirectionNum() {
        if (isLeftPressed() && isRightPressed()) {
            return 0;
        }
        else if (isLeftPressed()) {
            return -1;
        } else if (isRightPressed()) {
            return 1;
        } else {
            return 0;
        }
    }

    bool isSyncMode()     { return digitalRead(PIN_MODE)    == LOW; }
    bool isInverse()      { return digitalRead(PIN_INVERSE) == LOW; }

    ModeType getModeType() {
        if (digitalRead(PIN_MAN) == LOW)
            return ModeType::MANUAL;
        else if (digitalRead(PIN_SEQ) == LOW)
            return ModeType::SEQUENCE;
        else
            return ModeType::RANDOM;
    }

    float readFilteredPotPercent() {
        int raw = analogRead(PIN_POT);
        return map(raw, 0, 1024, 20, 100);
    }

    void setSignalLed(bool state) { digitalWrite(PIN_LED_SIGNAL, state ? HIGH : LOW); }
    void setLeftLed(bool state)   { digitalWrite(PIN_LED_LEFT,   state ? HIGH : LOW); }
    void setRightLed(bool state)  { digitalWrite(PIN_LED_RIGHT,  state ? HIGH : LOW); }

};
