krimarty/Siteshift_project/(commit log)

2025-07-12 schematic update
    [siteshift.kicad_pcb, siteshift.kicad_sch]
2025-07-12 Wire power distribution
    [siteshift.kicad_sch]
2025-07-12 Assign footprints
    [siteshift.kicad_sch]
2025-07-13 first pcb design
    [siteshift.kicad_pcb, siteshift.kicad_sch]
2025-07-14 PCB design update
    [siteshift.kicad_pcb, siteshift.kicad_sch]
2025-07-14 Changed orientation
    [siteshift.kicad_pcb]
2025-07-14 Changed name
    [siteshift.kicad_pcb]
2025-07-15 First code setup
    [siteshift.kicad_pcb, siteshift.kicad_sch]
2025-07-17 Motor class update
2025-07-17 Add class for buttons and communication
2025-07-18 communication + calibration state
2025-07-19 Random mode + LEDs
2025-08-15 Motor class tested
2025-08-15 Motor feedback tested
